D-Town44/sheltie/(commit log)

2020-03-17 Copy from corne
    [corne-classic.kicad_pcb, corne-classic.sch]
2020-03-23 removed corne classic and replaced with corne cherry
    [corne-cherry.kicad_pcb, corne-cherry.sch, corne-classic.kicad_pcb]
2020-03-23 worked on sheltie schematics. added new switches
    [sheltie.kicad_pcb, sheltie.sch]
